Sarthak-Deshmukh15/Novel-Quadcopter-Design-and-Development/README.md

# Novel-Quadcopter-Design-and-Development
This repository contains the work involved in accomplishing a novel quadcopter design.
