Sarthak-Deshmukh15/Novel-Quadcopter-Design-and-Development/stl-files/Left front connector 1.STL

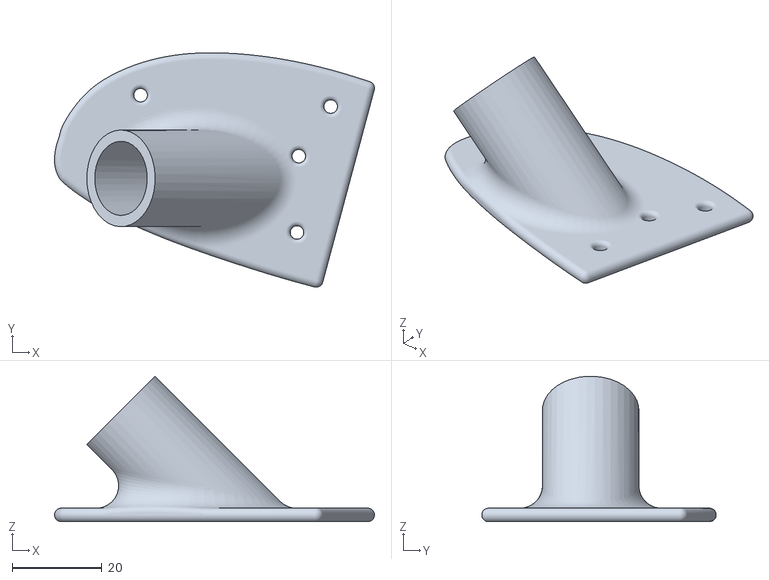
[picture p49: CAD file, 2026-04-22]
stl-files/Left front connector 1.STL
71.2 x 52.2 x 32.3
