Sarthak-Deshmukh15/Novel-Quadcopter-Design-and-Development/stl-files/Right back connector 1.STL

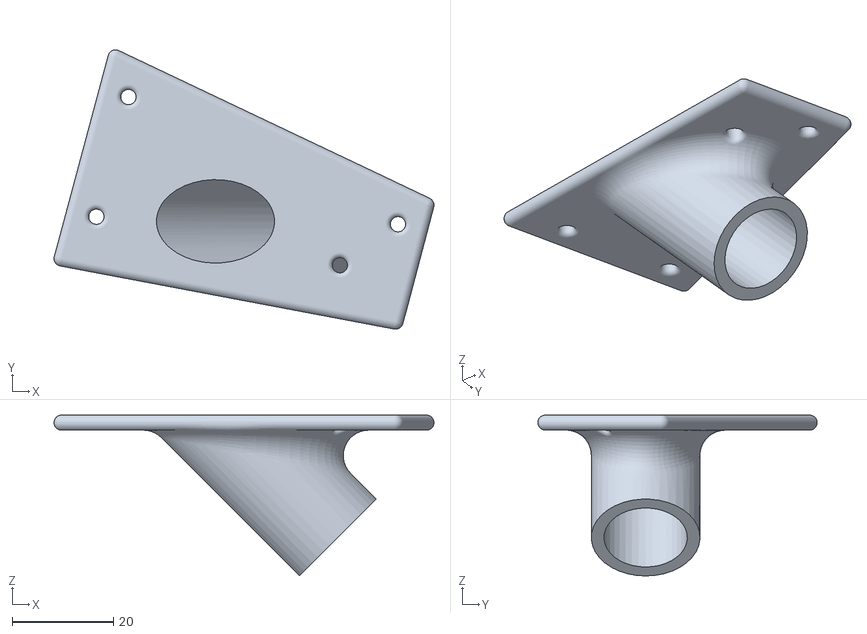
[picture p50: CAD file, 2026-04-22]
stl-files/Right back connector 1.STL
75.1 x 55.2 x 31.8
