Sarthak-Deshmukh15/Novel-Quadcopter-Design-and-Development/(list of files, cad)

Other CAD files:
stl-files/Right front connector 1.STL
stl-files/Left back connector 1.STL
